PetroBosak/harry-potter-quest/pcb/render-top-hat.png

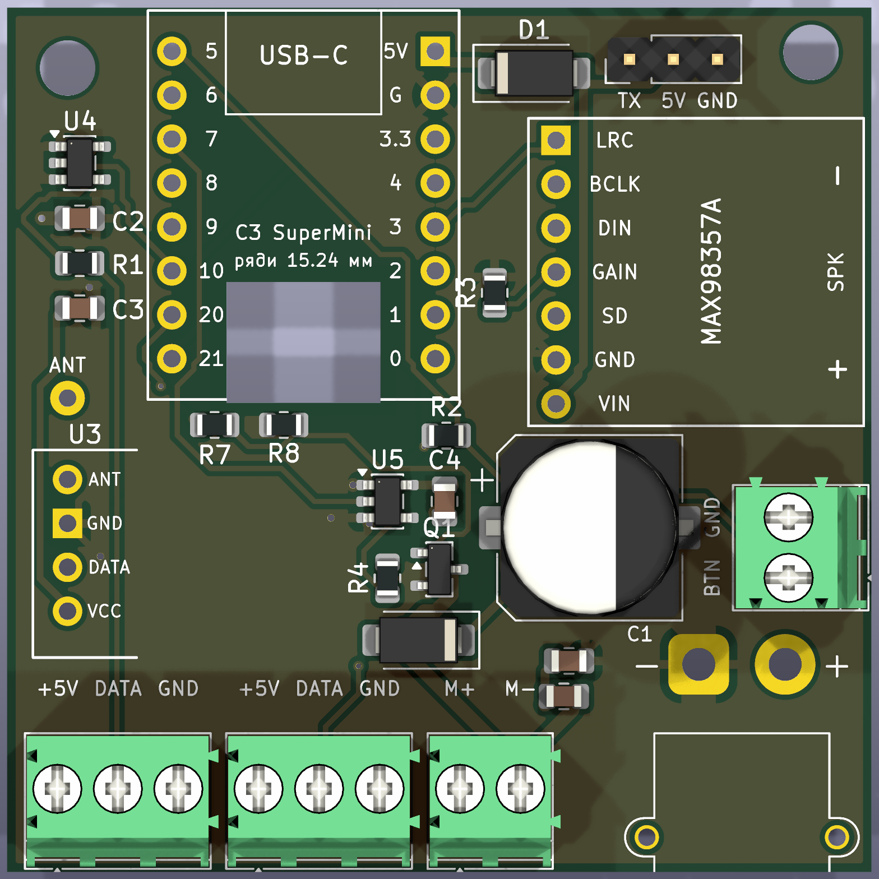
pcb/render-top-hat.png
