PetroBosak/harry-potter-quest/pcb/render-bottom-hat.png

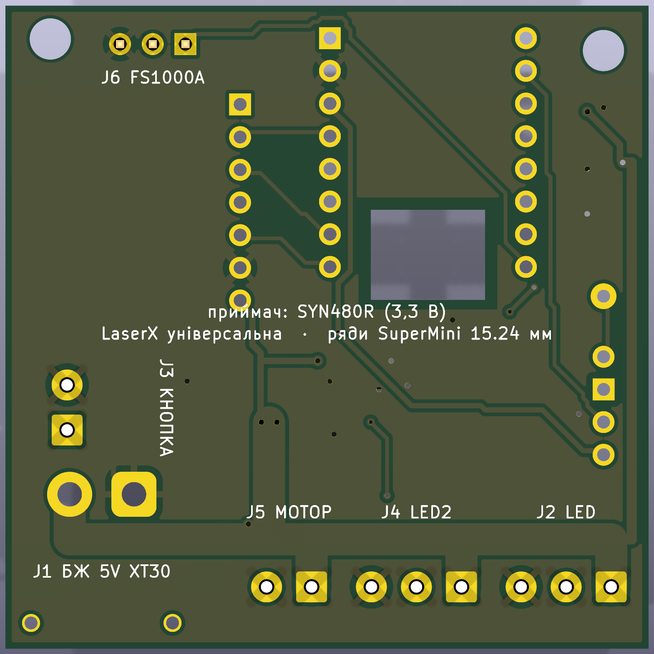
pcb/render-bottom-hat.png
