PetroBosak/harry-potter-quest/pcb/render-top-panel-hat.png

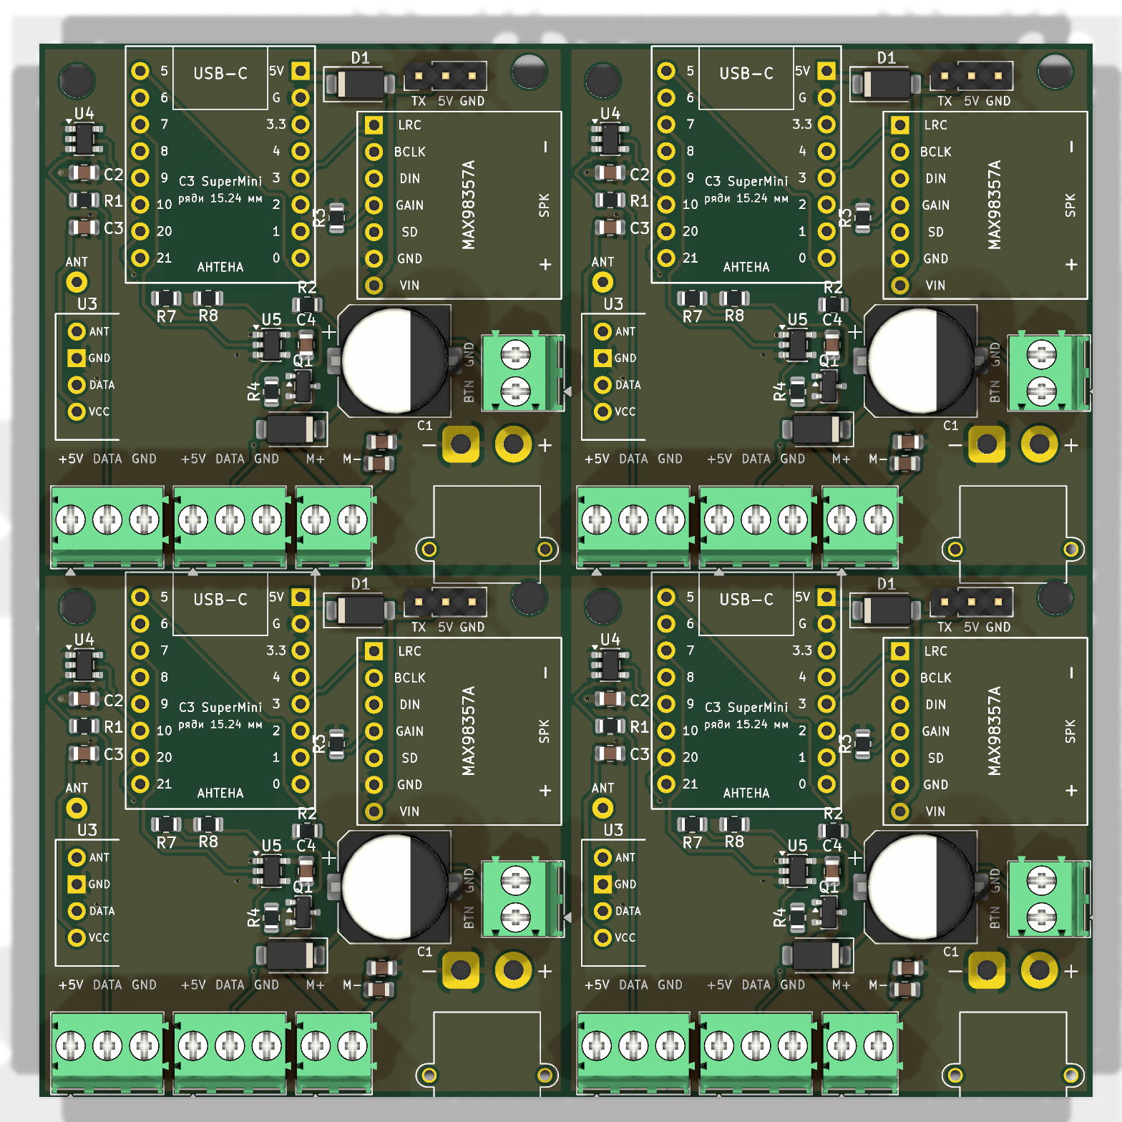
pcb/render-top-panel-hat.png
