PetroBosak/harry-potter-quest/pcb/routing-hat.png

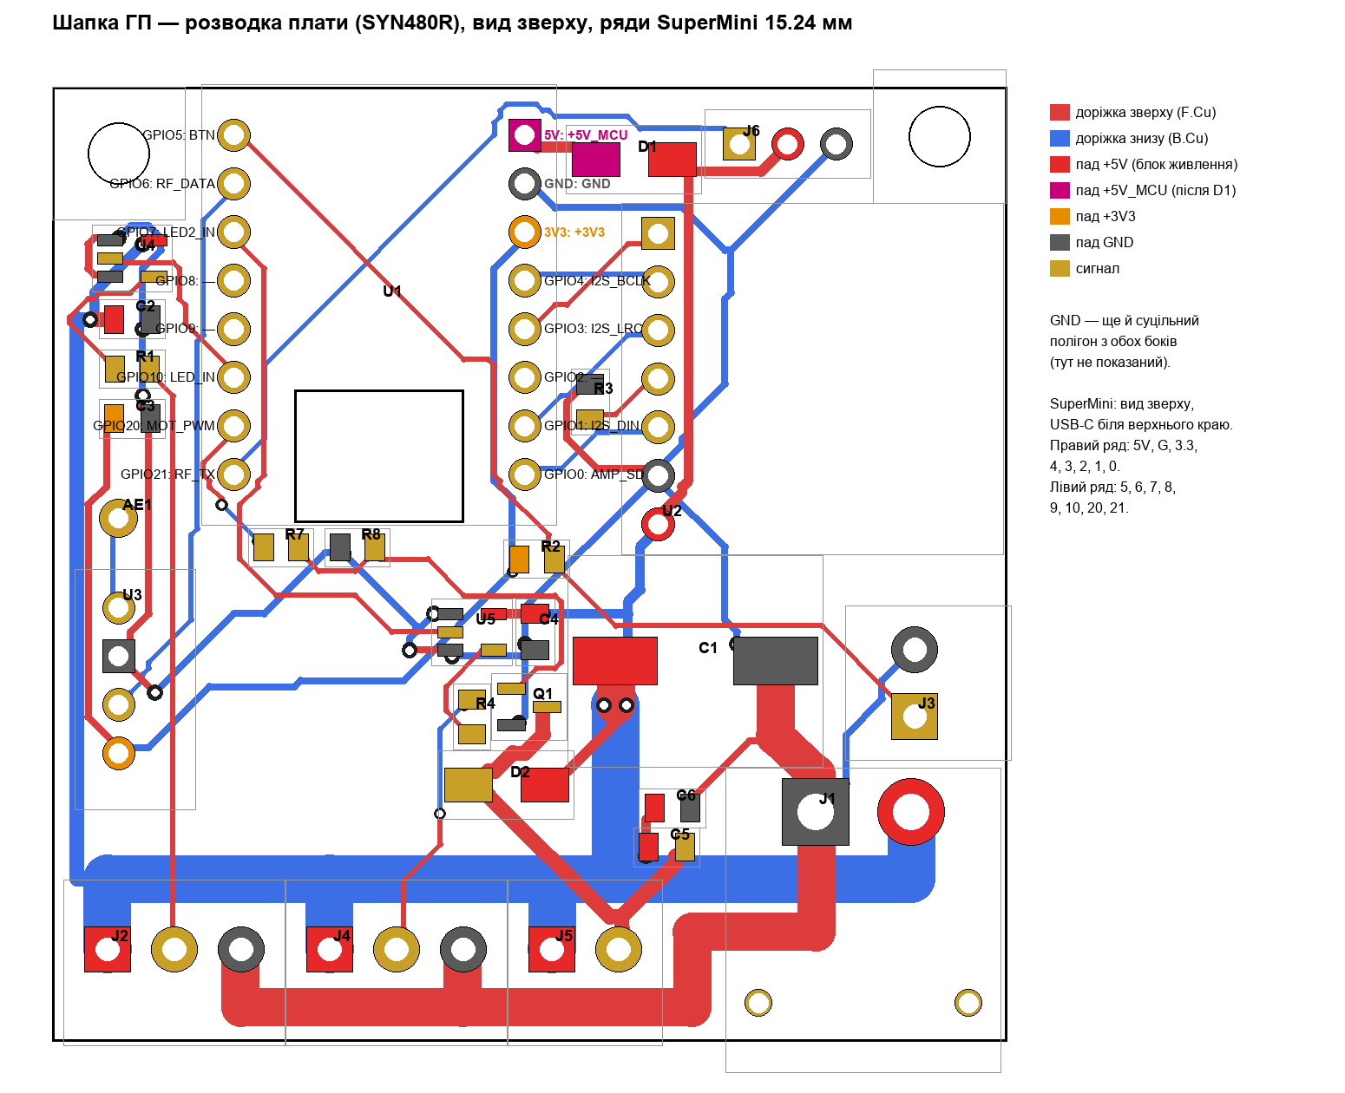
pcb/routing-hat.png
