PetroBosak/harry-potter-quest/pcb/BOM-hat.csv

Позиції | Номінал | Посадкове місце | Кількість
AE1 | дріт 17,3 см | shield67:ANT_Wire_Pad | 1
C1 | 1000uF 10V | Capacitor_SMD:CP_Elec_10x10.5 | 1
C2-C6 | 100nF | Capacitor_SMD:C_0805_2012Metric | 5
D1,D2 | SS34 | Diode_SMD:D_SMA | 2
J1 | XT30PW-M БЖ 5V | Connector_AMASS:AMASS_XT30PW-M_1x02_P2.50mm_Horizontal | 1
J2 | LED1 (стрічка/матриці) | TerminalBlock_Phoenix:TerminalBlock_Phoenix_PT-1,5-3-3.5-H_1x03_P3.50mm_Horizontal | 1
J3 | КНОПКА | TerminalBlock_Phoenix:TerminalBlock_Phoenix_PT-1,5-2-3.5-H_1x02_P3.50mm_Horizontal | 1
J4 | LED2 (стрічка/кільце) | TerminalBlock_Phoenix:TerminalBlock_Phoenix_PT-1,5-3-3.5-H_1x03_P3.50mm_Horizontal | 1
J5 | МОТОР | TerminalBlock_Phoenix:TerminalBlock_Phoenix_PT-1,5-2-3.5-H_1x02_P3.50mm_Horizontal | 1
J6 | FS1000A 433 TX | Connector_PinHeader_2.54mm:PinHeader_1x03_P2.54mm_Vertical | 1
Q1 | AO3400A | Package_TO_SOT_SMD:SOT-23 | 1
R1,R4 | 330 | Resistor_SMD:R_0805_2012Metric | 2
R2,R8 | 10k | Resistor_SMD:R_0805_2012Metric | 2
R3 | 100k | Resistor_SMD:R_0805_2012Metric | 1
R7 | 100 | Resistor_SMD:R_0805_2012Metric | 1
U1 | ESP32-C3 SuperMini | shield67:ESP32-C3_SuperMini_Socket | 1
U2 | MAX98357A модуль | shield67:MAX98357A_Module_Socket | 1
U3 | SYN480R 433 МГц | shield67:SYN480R_Socket | 1
U4,U5 | 74AHCT1G125 | Package_TO_SOT_SMD:SOT-23-5 | 2
U1 | Гребінка мама 1x8, крок 2,54, пряма | — | 2
U2 | Гребінка мама 1x7, крок 2,54, пряма | — | 1
U3 | Гребінка мама 1x4, крок 2,54, пряма | — | 1
