PetroBosak/harry-potter-quest/docs/wiring-hat.png

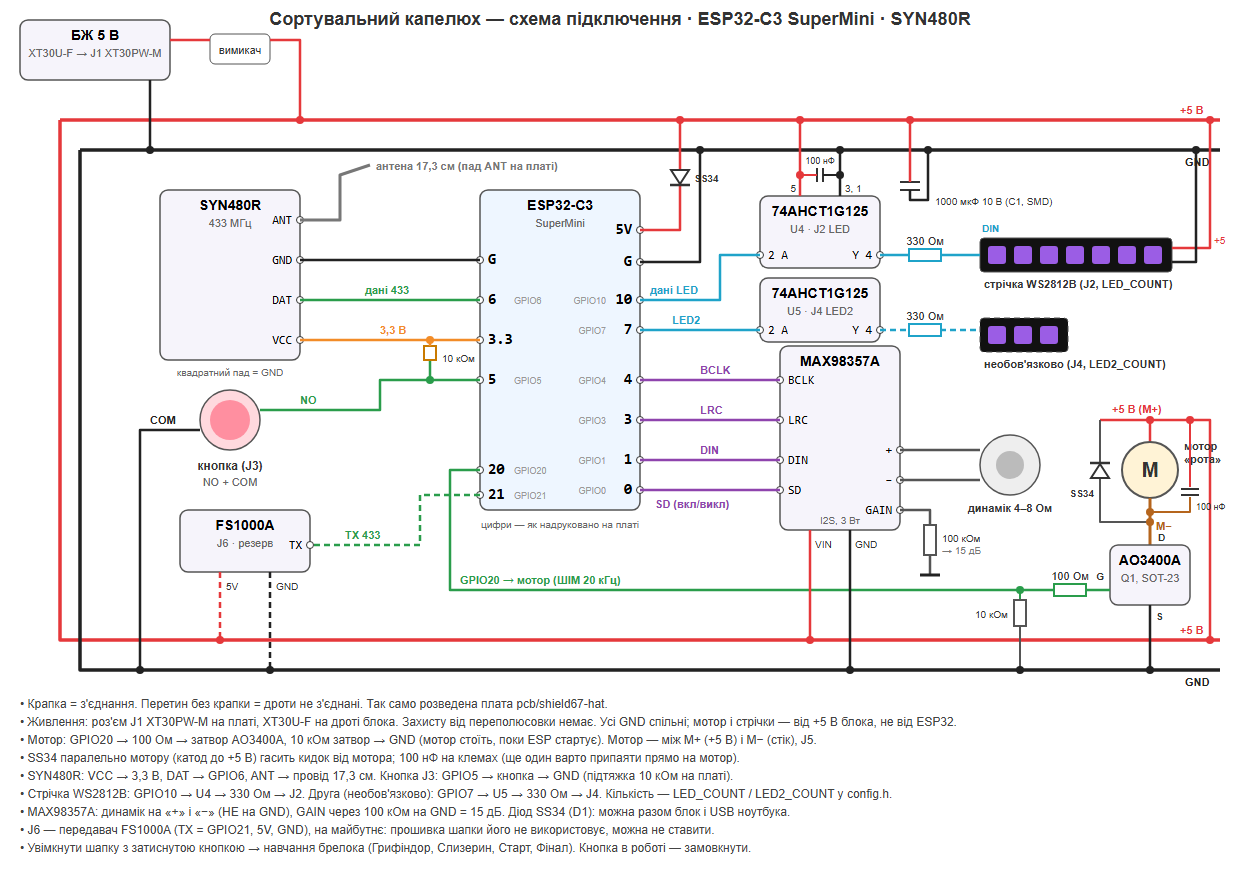
docs/wiring-hat.png
