PetroBosak/harry-potter-quest/pcb/shield67-hat-schematic.pdf

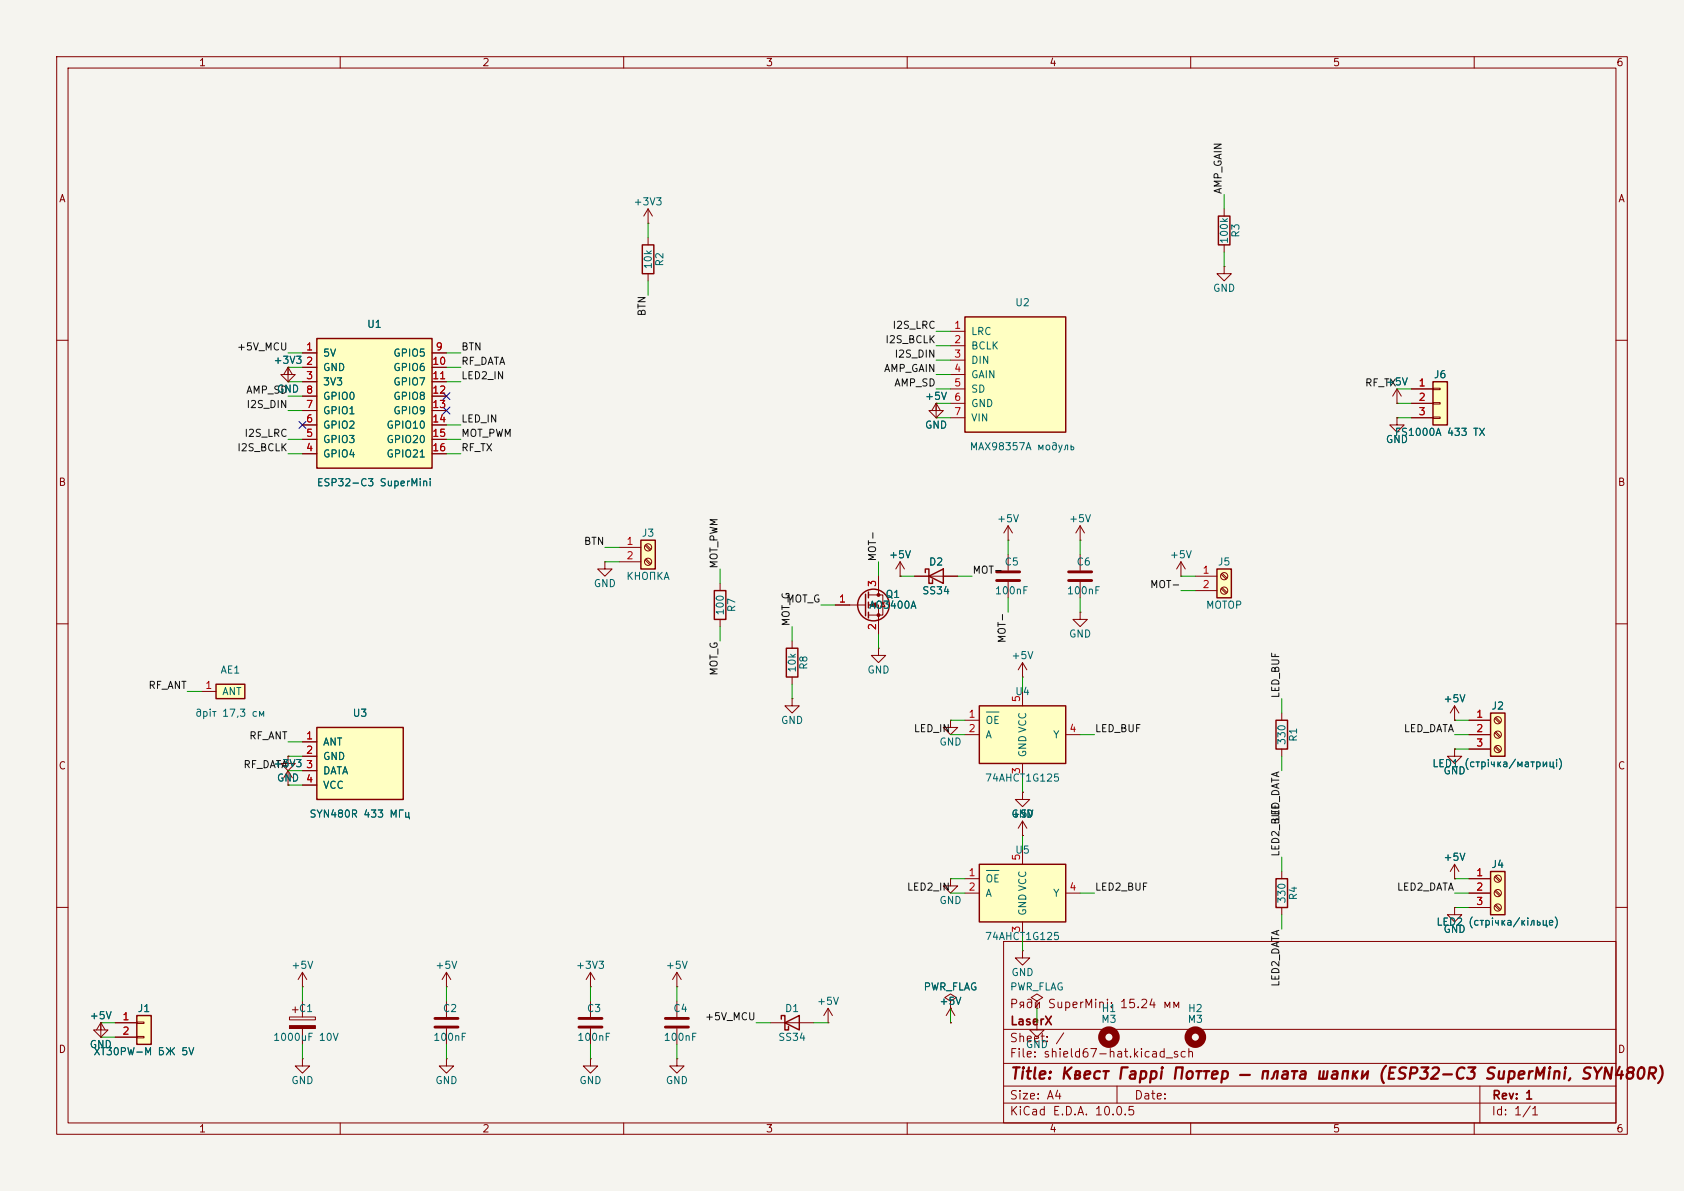
[picture p6: page 1]

Ряди SuperMini: 15.24 мм
LaserX
Sheet: /
File: shield67-hat.kicad_sch
Title: Квест Гаррі Поттер — плата шапки (ESP32-C3 SuperMini, SYN480R)

Size: A4 | Rev: 1
KiCad E.D.A. 10.0.5 | Id: 1/1
