PetroBosak/harry-potter-quest/pcb/shield67-hat.kicad_pcb

## KiCad design pcb/shield67-hat.kicad_pcb (2026-11-05)

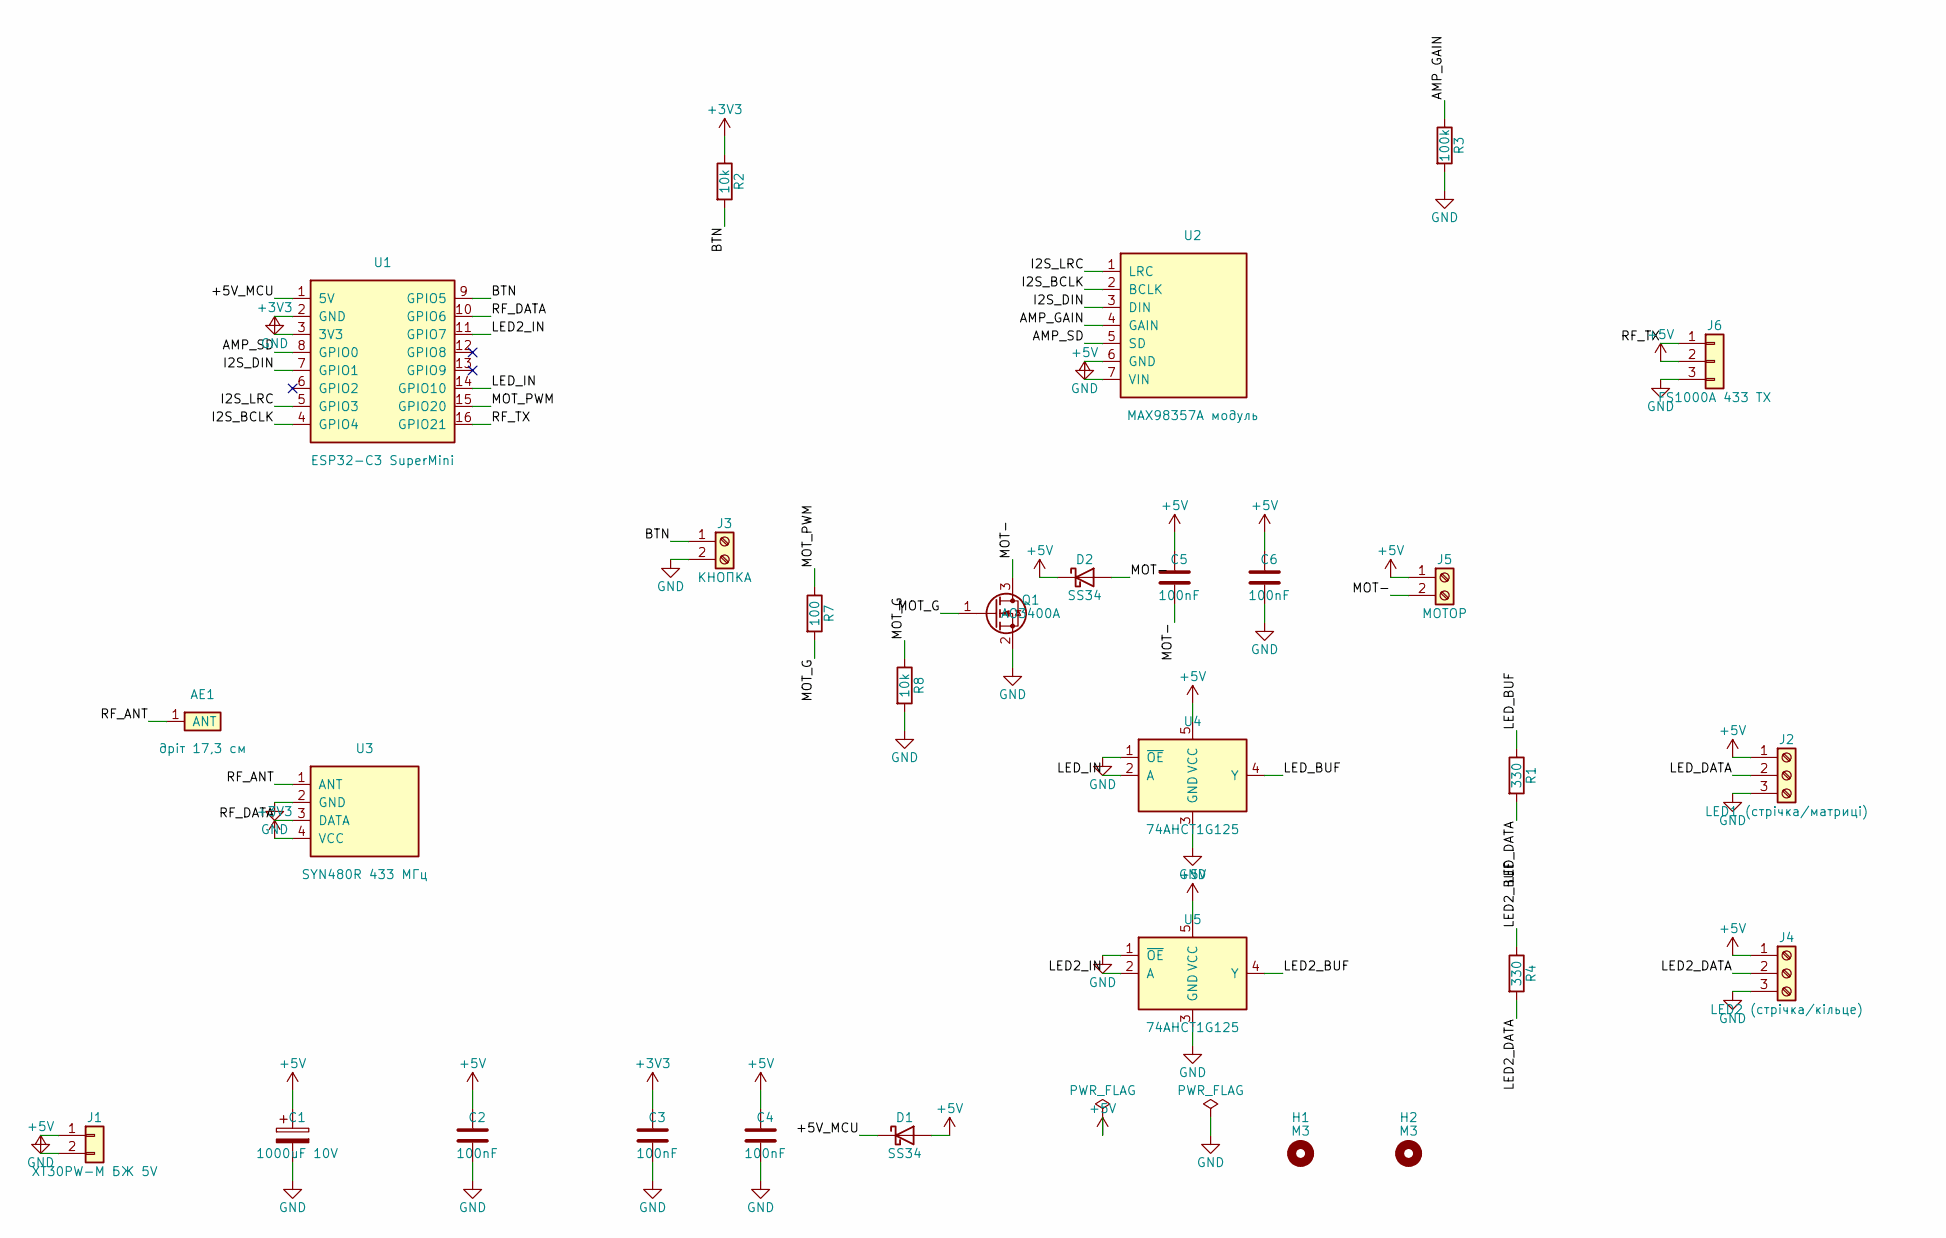
[picture p7: schematic shield67-hat.kicad_sch, Квест Гаррі Поттер — плата шапки (ESP32-C3 SuperMini, SYN48…]

Parts:
AE1: дріт 17,3 см; ANT_Wire_Pad
C1: 1000uF 10V; CP_Elec_10x10.5
C2, C3, C4, C5, C6: 100nF; C_0805_2012Metric
D1, D2: SS34; D_SMA
H1, H2: M3; MountingHole_3.2mm_M3
J1: XT30PW-M БЖ 5V; AMASS_XT30PW-M_1x02_P2.50mm_Horizontal
J2: LED1 (стрічка/матриці); TerminalBlock_Phoenix_PT-1,5-3-3.5-H_1x03_P3.50mm_Horizontal
J3: КНОПКА; TerminalBlock_Phoenix_PT-1,5-2-3.5-H_1x02_P3.50mm_Horizontal
J4: LED2 (стрічка/кільце); TerminalBlock_Phoenix_PT-1,5-3-3.5-H_1x03_P3.50mm_Horizontal
J5: МОТОР; TerminalBlock_Phoenix_PT-1,5-2-3.5-H_1x02_P3.50mm_Horizontal
J6: FS1000A 433 TX; PinHeader_1x03_P2.54mm_Vertical
Q1: AO3400A; SOT-23
R1, R4: 330; R_0805_2012Metric
R2, R8: 10k; R_0805_2012Metric
R3: 100k; R_0805_2012Metric
R7: 100; R_0805_2012Metric
U1: ESP32-C3 SuperMini; ESP32-C3_SuperMini_Socket
U2: MAX98357A модуль; MAX98357A_Module_Socket
U3: SYN480R 433 МГц; SYN480R_Socket
U4, U5: 74AHCT1G125; SOT-23-5

Connections:
+3V3: C3.1, R2.1, U1.3 (3V3), U3.4 (VCC)
+5V: C1.1, C2.1, C4.1, C5.1, C6.1, D1.2 (A), D2.1 (K), J1.2, J2.1, J4.1, J5.1, J6.2, U2.7 (VIN), U4.5 (VCC), U5.5 (VCC)
/+5V_MCU: D1.1 (K), U1.1 (5V)
/AMP_GAIN: R3.1, U2.4 (GAIN)
/AMP_SD: U1.8 (GPIO0), U2.5 (SD)
/BTN: J3.1, R2.2, U1.9 (GPIO5)
/I2S_BCLK: U1.4 (GPIO4), U2.2 (BCLK)
/I2S_DIN: U1.7 (GPIO1), U2.3 (DIN)
/I2S_LRC: U1.5 (GPIO3), U2.1 (LRC)
/LED2_BUF: R4.1, U5.4 (Y)
/LED2_DATA: J4.2, R4.2
/LED2_IN: U1.11 (GPIO7), U5.2 (A)
/LED_BUF: R1.1, U4.4 (Y)
/LED_DATA: J2.2, R1.2
/LED_IN: U1.14 (GPIO10), U4.2 (A)
/MOT-: C5.2, D2.2 (A), J5.2, Q1.3 (D)
/MOT_G: Q1.1 (G), R7.2, R8.1
/MOT_PWM: R7.1, U1.15 (GPIO20)
/RF_ANT: AE1.1, U3.1 (ANT)
/RF_DATA: U1.10 (GPIO6), U3.3 (DATA)
/RF_TX: J6.1, U1.16 (GPIO21)
GND: C1.2, C2.2, C3.2, C4.2, C6.2, J1.1, J2.3, J3.2, J4.3, J6.3, Q1.2 (S), R3.2, R8.2, U1.2 (GND), U2.6 (GND), U3.2 (GND), U4.1 (~OE), U4.3 (GND), U5.1 (~OE), U5.3 (GND)

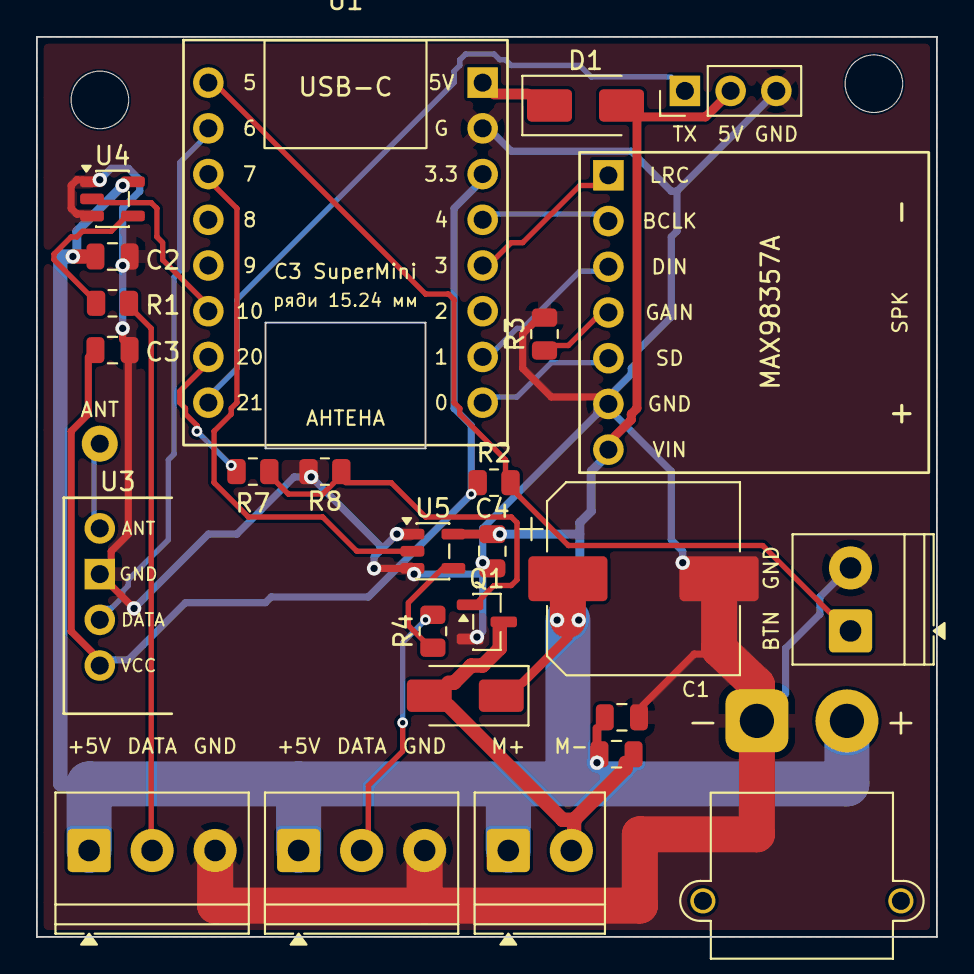
[picture p8: board shield67-hat.kicad_pcb from above]

Board: 2 copper layers, 50.0 x 50.0 mm, 29 parts (0 on the bottom side), 22 nets.
