PetroBosak/harry-potter-quest/firmware/hat/mouth.h

// Рухи «рота» (мотора) під кожну фразу: мс увімкнено, мс вимкнено, мс увімкнено, ...
// Перенесено зі старої прошивки hate_hogrards.ino (там реле). Відлік — через MOUTH_DELAY_MS після старту фрази.
// Новий трек або інша озвучка — змініть рядок з тим самим номером.
#pragma once
#include <Arduino.h>

static const uint16_t MOUTH_1[] = {400, 600, 500, 500, 800, 400, 700, 400, 900, 800, 900, 300, 700, 100};
static const uint16_t MOUTH_2[] = {1600, 400, 1400, 300, 600, 800, 700, 100};
static const uint16_t MOUTH_3[] = {1000, 1000, 1800, 700, 1000, 800, 600, 900, 1100, 100};
static const uint16_t MOUTH_4[] = {1100, 200, 800, 800, 900, 900, 1100, 800, 1200, 400, 1600, 100};
static const uint16_t MOUTH_5[] = {1400, 400, 1300, 800, 700, 800, 1500, 500, 900, 300, 900, 300, 1200, 500, 1800, 100};
static const uint16_t MOUTH_6[] = {600, 600, 900, 900, 2600, 1100, 700, 400, 1000, 1000, 1000, 1200, 900, 100};
static const uint16_t MOUTH_7[] = {2000, 700, 1100, 600, 1200, 500, 600, 300, 800, 600, 800, 400, 1100, 900, 600, 800, 1000, 100};
static const uint16_t MOUTH_8[] = {2300, 600, 900, 600, 600, 100};
static const uint16_t MOUTH_9[] = {800, 400, 600, 400, 700, 900, 1000, 500, 1200, 700, 700, 400, 300, 200, 500, 700, 500, 100};
static const uint16_t MOUTH_10[] = {1000, 1000, 800, 900, 1000, 1100, 3000, 900, 1500, 1000, 2100, 1000, 3000, 100};
static const uint16_t MOUTH_11[] = {600, 300, 500, 800, 1900, 500, 2100, 400, 800, 700, 1000, 100};
static const uint16_t MOUTH_12[] = {1200, 400, 1000, 400, 900, 400, 1000, 800, 900, 300, 900, 400, 1100, 700, 800, 100};
static const uint16_t MOUTH_13[] = {1000, 500, 3500, 800, 2200, 600, 1700, 400, 1500, 700, 500, 400, 700, 100};
static const uint16_t MOUTH_14[] = {3000, 400, 1300, 400, 1600, 100};
static const uint16_t MOUTH_15[] = {2800, 1100, 1200, 900, 1000, 200, 1000, 100};
static const uint16_t MOUTH_16[] = {2600, 500, 2000, 700, 1700, 500, 2600, 400, 2400, 100};
static const uint16_t MOUTH_17[] = {900, 500, 2300, 800, 1200, 400, 800, 400, 900, 300, 2300, 600};
static const uint16_t MOUTH_18[] = {1800, 300, 2700, 500, 1200, 300, 2100, 100};

struct Mouth { const uint16_t *steps; uint8_t count; };
#define M(n) {MOUTH_##n, sizeof(MOUTH_##n) / sizeof(MOUTH_##n[0])}
static const Mouth MOUTHS[] = {
  {nullptr, 0},
  M(1), M(2), M(3), M(4), M(5), M(6), M(7), M(8), M(9),
  M(10), M(11), M(12), M(13), M(14), M(15), M(16), M(17), M(18),
};
#undef M
static const uint8_t MOUTH_COUNT = sizeof(MOUTHS) / sizeof(MOUTHS[0]);
