PetroBosak/harry-potter-quest/(commit log)

2026-10-30 Sorting hat firmware: embedded ADPCM phrases, mouth motor with soft start, wiring diagram
    Ported from the old Arduino/DFPlayer/relay sketch (ref/): same 4 fob codes and phrase
    groups, mouth timings in mouth.h; motor via AO3400A on GPIO20 (LEDC PWM, ramp),
    WS2812B light, stop button, fob learning. Compiles for ESP32-C3 SuperMini (huge_app).
2026-11-04 PCB for the hat: gerbers, BOM, schematic, KiCad project (from challenge-duel, variant hat)
    [BOM-hat.csv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]
2026-11-04 pcb: 2x2 V-cut panel 100x100 (4 boards) for ordering, JLCPCB notes
    [panel-hat-B_Cu.gbl, panel-hat-B_Mask.gbs, panel-hat-B_Paste.gbp, panel-hat-B_Silkscreen.gbo, panel-hat-Edge_Cuts.gm1, panel-hat-F_Cu.gtl, panel-hat-F_Mask.gts, panel-hat-F_Paste.gtp]
2026-11-05 pcb: C1 is SMD 1000uF 10V 10x10.5 (Hitano ELV102M10RF); board and panel rebuilt
    [BOM-hat.csv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]
2026-11-05 Docs for the updated hat board: XT30 on J1, J6 FS1000A, SMD C1, panel gerbers
    Wiring diagram and README no longer call J1 a screw terminal, show the J6 header
    on GPIO21 (unused by the firmware) and point to pcb/. No firmware changes.
    [wiring_hat.py]
2026-11-05 pcb: silkscreen overlaps fixed, universal J2/J4 names in BOM; board and panel rebuilt
    [BOM-hat.csv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]
2026-11-05 README: motor voltage confirmed, 5 V
2026-11-05 Firmware: hold GPIO21 LOW from the start of setup(), motor 5 V confirmed in CLAUDE.md
    Keeps an FS1000A in J6 from transmitting and jamming the receiver. Pins in config.h
    checked against the board: BCLK 4, LRC 3, DIN 1, SD 0. Compiles for C3 (huge_app).
    [config.h, hat.ino]
